joelucedo/MY-KICAD-LIBRARY/MY 3D MODELS/LED0603_BLUE.STEP

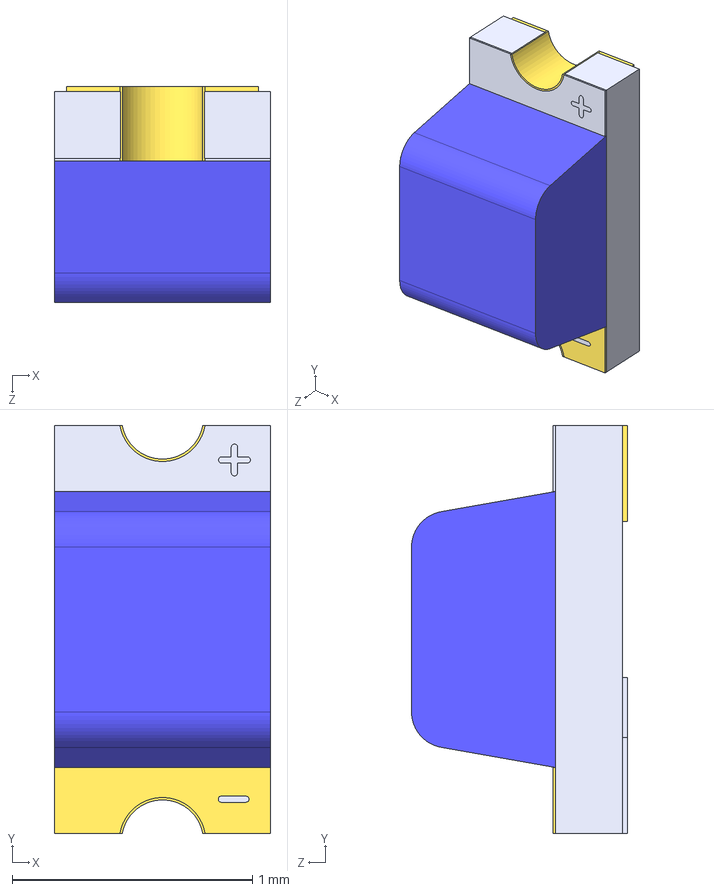
[picture p1: CAD file, 2023-07-05]
MY 3D MODELS/LED0603_BLUE.STEP
0.9 x 1.70 x 0.9 mm
User_Library-LTST-C190GKT_Pad005
User_Library-LTST-C190GKT_Pad001
User_Library-LTST-C190GKT_Pad006
User_Library-LTST-C190GKT_Pad004
User_Library-LTST-C190GKT_Pad003
User_Library-LTST-C190GKT_Pad007
User_Library-LTST-C190GKT_Lens
User_Library-LTST-C190GKT_Pad
String+
String-
