joelucedo/MY-KICAD-LIBRARY/MY 3D MODELS/VLS4012ET-4R7M.STEP

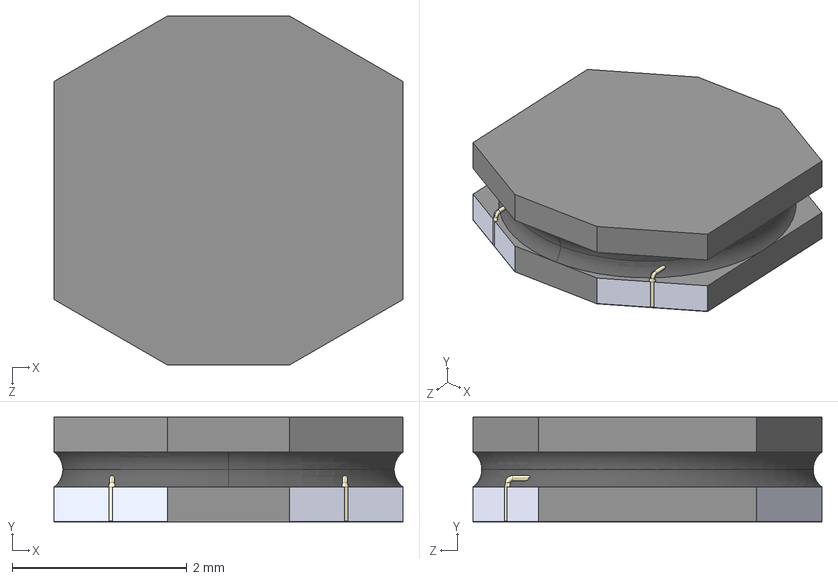
[picture p2: CAD file, 2023-07-02]
MY 3D MODELS/VLS4012ET-4R7M.STEP
4.00 x 1.20 x 4.00 mm
