joelucedo/MY-KICAD-LIBRARY/MY 3D MODELS/USBLC6-2SC6.step

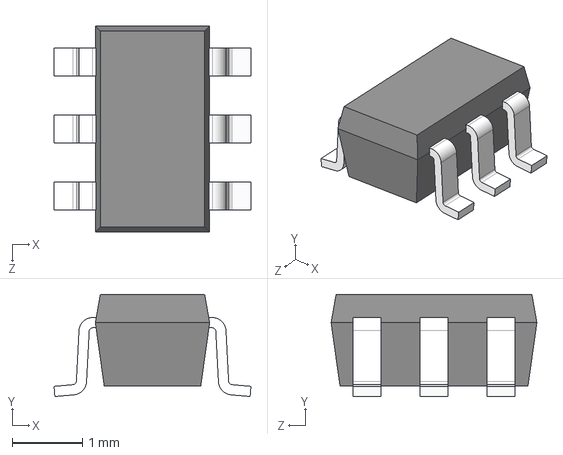
[picture p3: CAD file, 2023-07-01]
MY 3D MODELS/USBLC6-2SC6.step
2.80 x 1.45 x 2.92 mm
