joelucedo/MY-KICAD-LIBRARY/MY 3D MODELS/Inductor_CD32.STEP

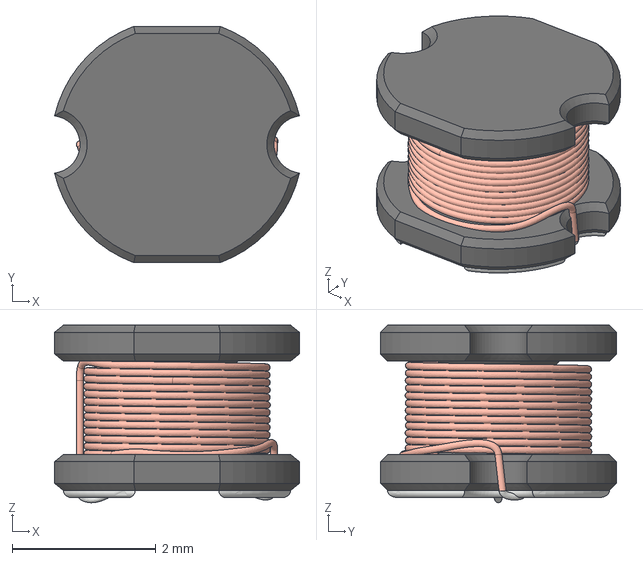
[picture p4: CAD file, 2023-07-01]
MY 3D MODELS/Inductor_CD32.STEP
3.41 x 3.29 x 2.47 mm
