joelucedo/MY-KICAD-LIBRARY/MY 3D MODELS/IRLML6401.stp

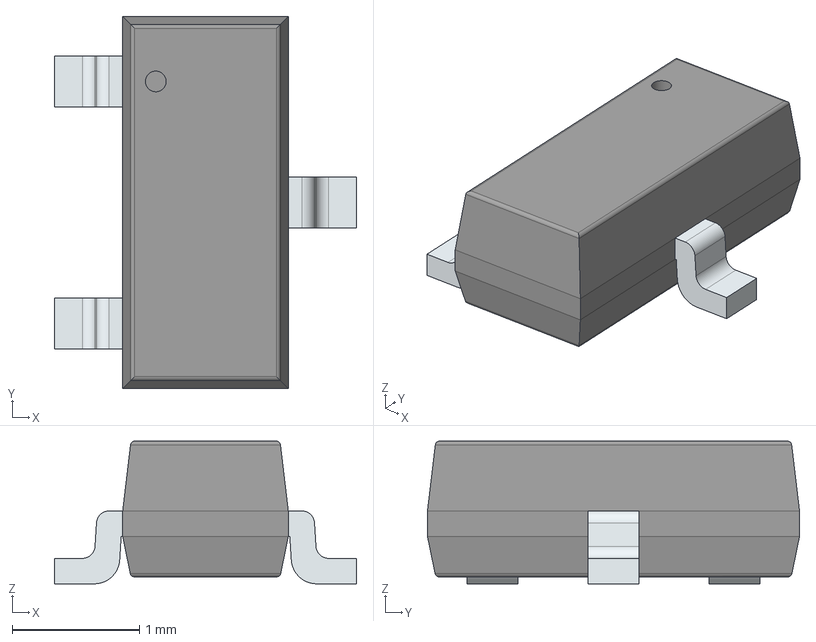
[picture p5: CAD file, 2023-06-07]
MY 3D MODELS/IRLML6401.stp
2.37 x 2.92 x 1.12 mm
PinsArrayL
FilletPinR
