joelucedo/MY-KICAD-LIBRARY/MY 3D MODELS/IS25WP064A-JBLE.stp

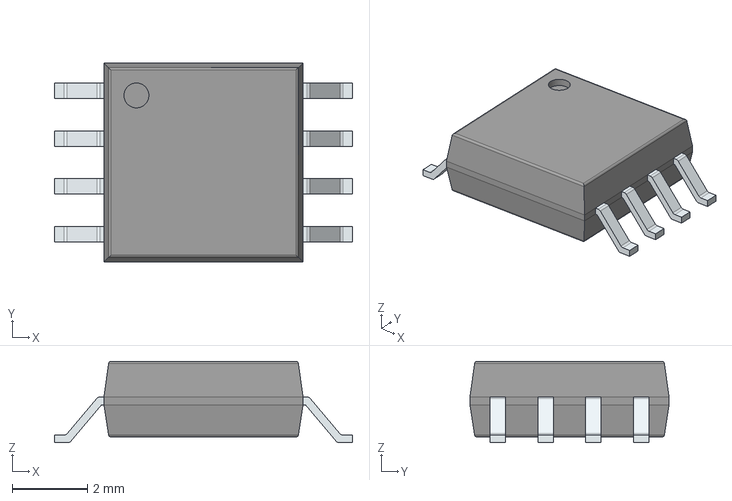
[picture p6: CAD file, 2023-06-07]
MY 3D MODELS/IS25WP064A-JBLE.stp
7.90 x 5.28 x 2.16 mm
PinsArrayLR
