joelucedo/MY-KICAD-LIBRARY/MY 3D MODELS/UM803RS.stp

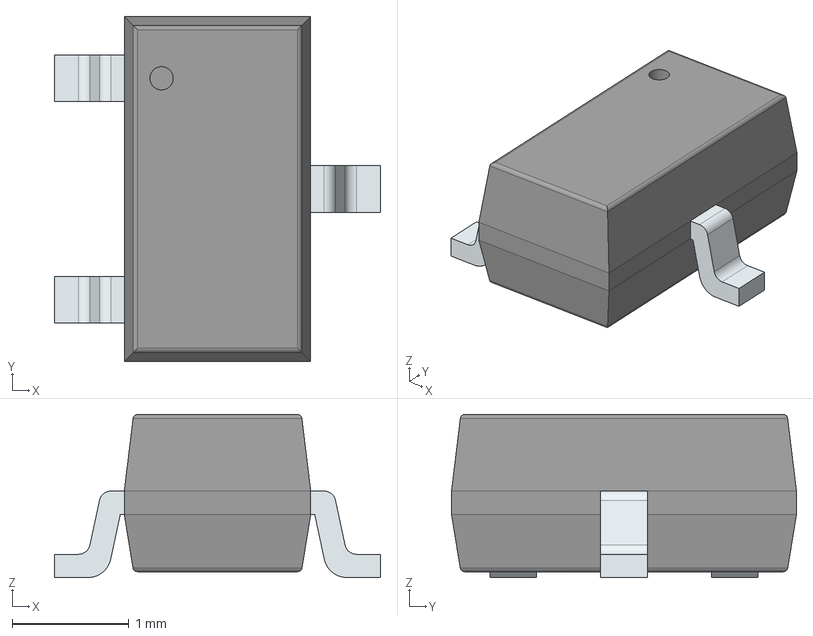
[picture p7: CAD file, 2023-06-07]
MY 3D MODELS/UM803RS.stp
2.80 x 2.96 x 1.40 mm
PinsArrayL
FilletPinR
