joelucedo/MY-KICAD-LIBRARY/MY 3D MODELS/UM805RE.STEP

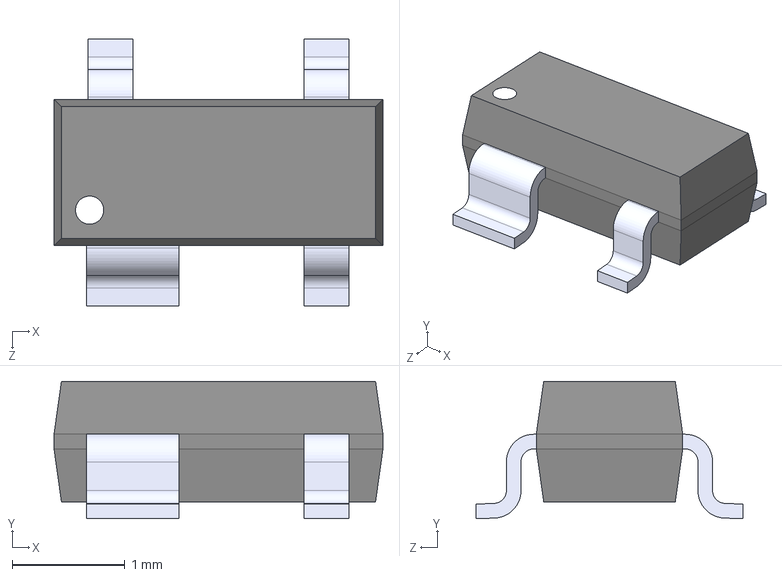
[picture p8: CAD file, 2023-06-07]
MY 3D MODELS/UM805RE.STEP
2.92 x 1.22 x 2.37 mm
