joelucedo/MY-KICAD-LIBRARY/MY 3D MODELS/XL7EL89CMI-111YLC-24M.stp

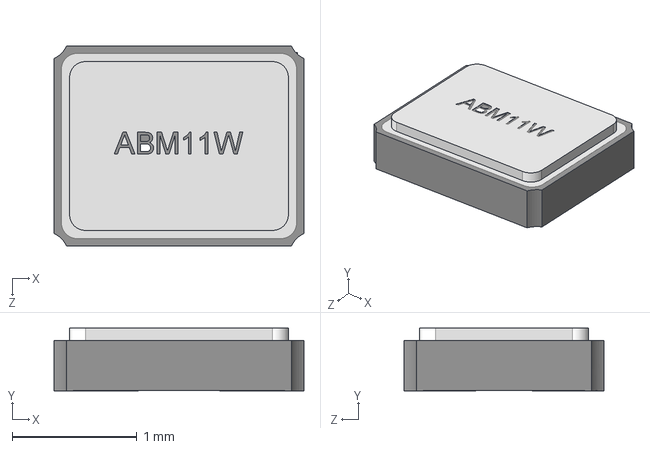
[picture p9: CAD file, 2023-06-07]
MY 3D MODELS/XL7EL89CMI-111YLC-24M.stp
2.00 x 0.5 x 1.60 mm
