joelucedo/MY-KICAD-LIBRARY/MY 3D MODELS/BLM18AG121SN1D.stp

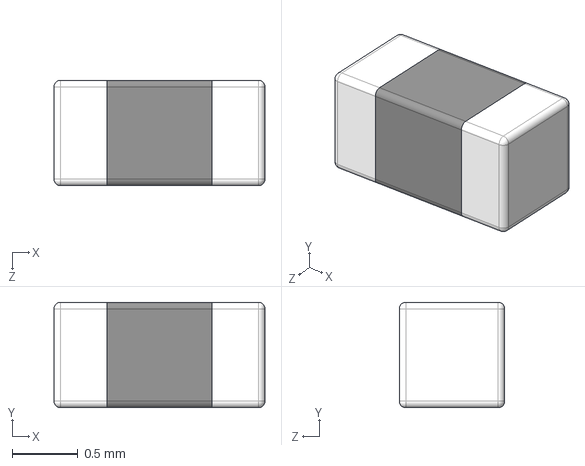
[picture p10: CAD file, 2023-06-07]
MY 3D MODELS/BLM18AG121SN1D.stp
1.60 x 0.8 x 0.8 mm
