joelucedo/MY-KICAD-LIBRARY/MY 3D MODELS/MIMXRT1064CVL5B.stp

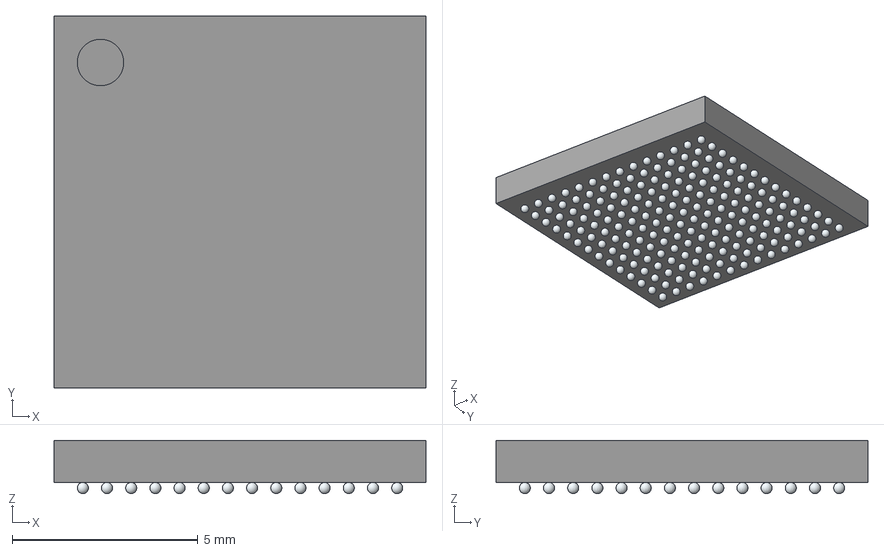
[picture p11: CAD file, 2023-06-07]
MY 3D MODELS/MIMXRT1064CVL5B.stp
10.0 x 10.0 x 1.43 mm
