joelucedo/MY-KICAD-LIBRARY/MY 3D MODELS/RB521S30.STEP

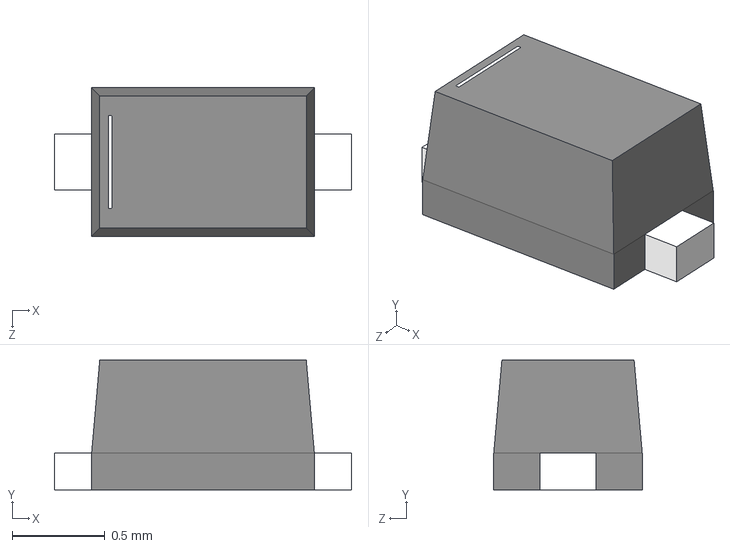
[picture p12: CAD file, 2023-06-07]
MY 3D MODELS/RB521S30.STEP
1.60 x 0.7 x 0.8 mm
