joelucedo/MY-KICAD-LIBRARY/MY 3D MODELS/SY8089AAAC.STEP

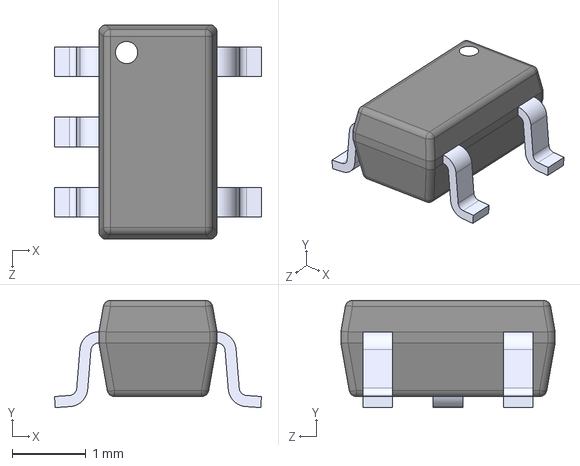
[picture p14: CAD file, 2023-06-07]
MY 3D MODELS/SY8089AAAC.STEP
2.80 x 1.45 x 2.90 mm
