joelucedo/MY-KICAD-LIBRARY/MY 3D MODELS/SP0503BAHTG.stp

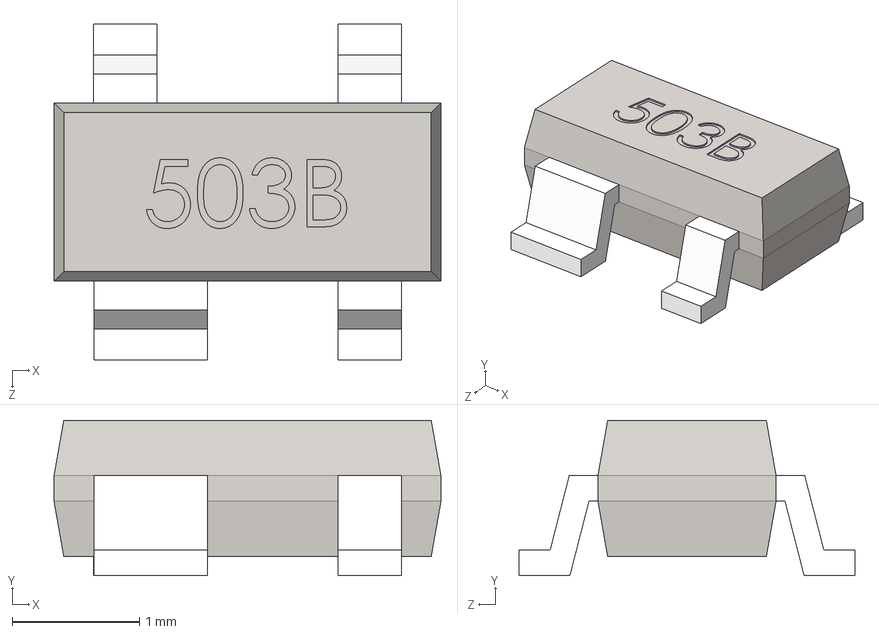
[picture p15: CAD file, 2023-06-07]
MY 3D MODELS/SP0503BAHTG.stp
3.04 x 1.22 x 2.64 mm
