joelucedo/MY-KICAD-LIBRARY/MY 3D MODELS/7V24000026.STEP

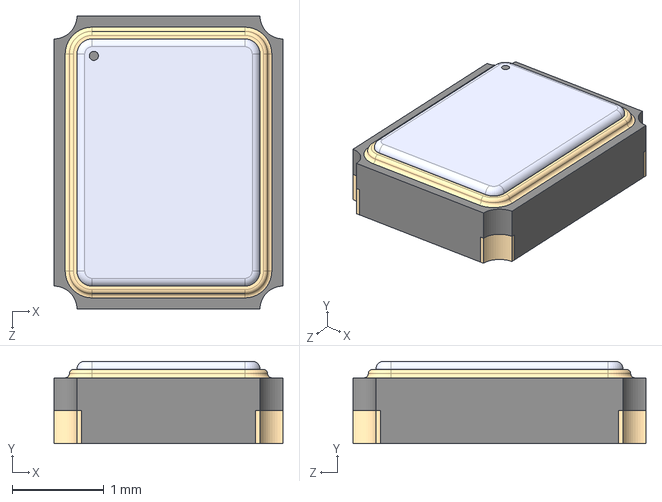
[picture p16: CAD file, 2023-06-07]
MY 3D MODELS/7V24000026.STEP
2.50 x 0.9 x 3.20 mm
