joelucedo/MY-KICAD-LIBRARY/MY 3D MODELS/WM8978CGEFL_RV.stp

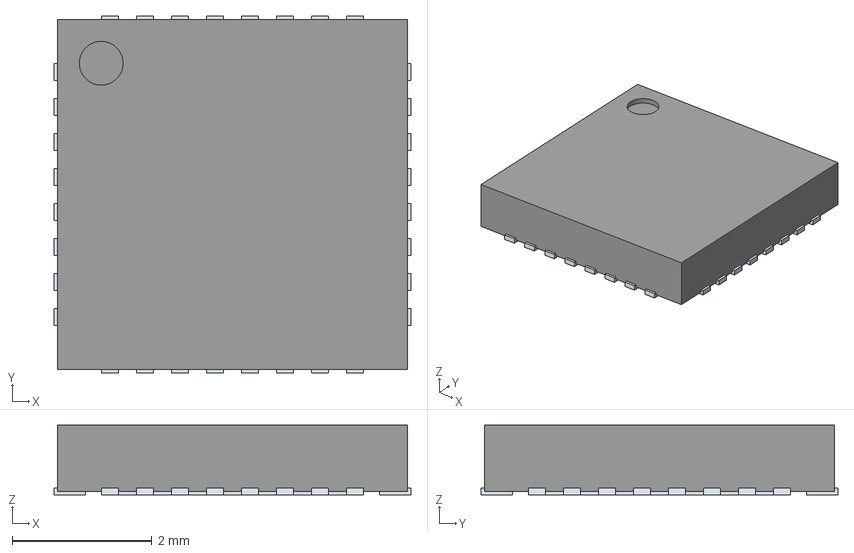
[picture p18: CAD file, 2023-06-07]
MY 3D MODELS/WM8978CGEFL_RV.stp
5.10 x 5.10 x 1.00 mm
ThermalPin
PinsArrayLR
PinsArrayTB
