joelucedo/MY-KICAD-LIBRARY/MY 3D MODELS/Q13FC1350000200.STEP

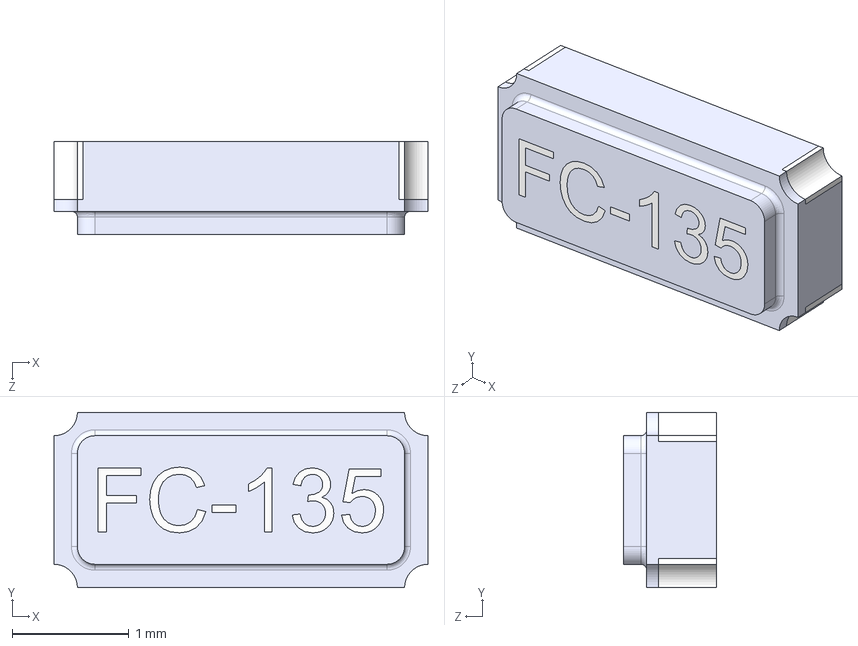
[picture p19: CAD file, 2023-06-07]
MY 3D MODELS/Q13FC1350000200.STEP
3.20 x 1.50 x 0.8 mm
Pin 2
Pin 1
Tekst Inlay
