joelucedo/MY-KICAD-LIBRARY/MY 3D MODELS/801-87-008-10-001101.stp

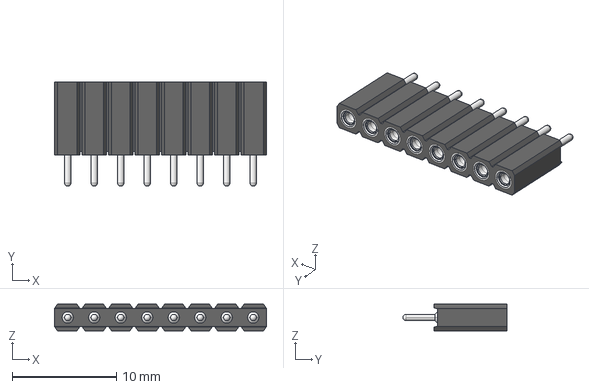
[picture p20: CAD file, 2023-06-02]
MY 3D MODELS/801-87-008-10-001101.stp
20.3 x 10.00 x 2.54 mm
