joelucedo/MY-KICAD-LIBRARY/MY 3D MODELS/RK09D1130C2P.stp

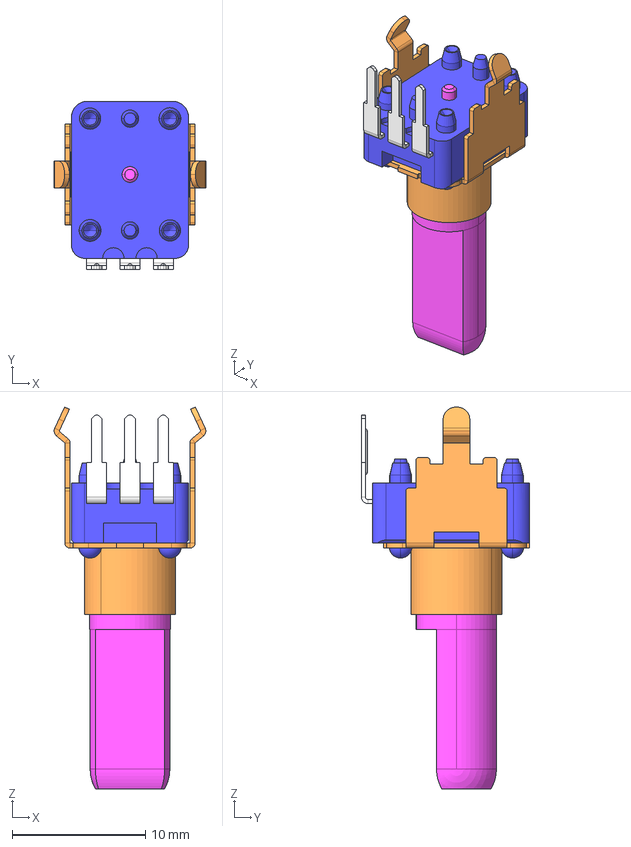
[picture p21: CAD file, 2023-06-02]
MY 3D MODELS/RK09D1130C2P.stp
11.4 x 12.7 x 28.7 mm
