joelucedo/MY-KICAD-LIBRARY/MY 3D MODELS/ESP32-WROVER-IE_(16MB).step

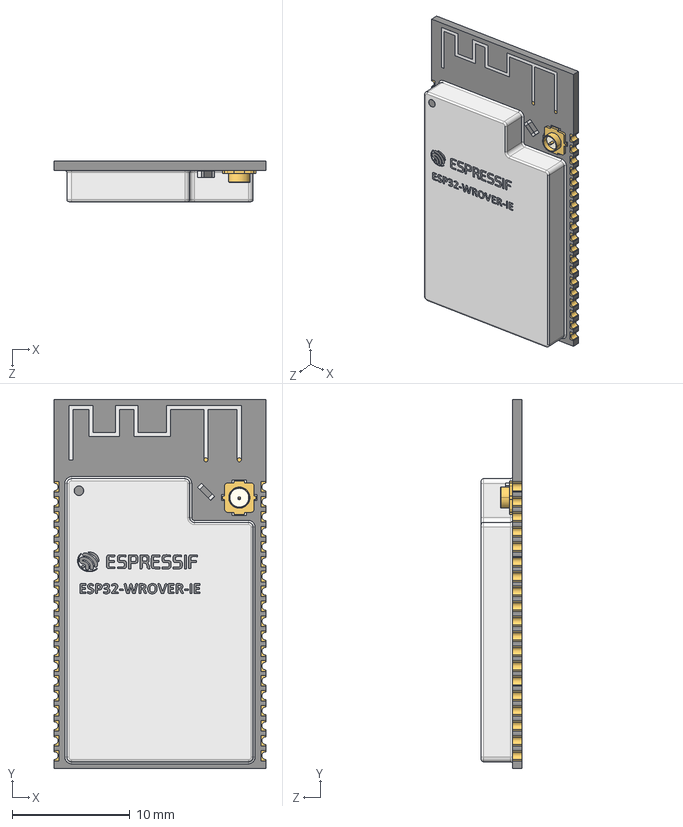
[picture p22: CAD file, 2023-06-02]
MY 3D MODELS/ESP32-WROVER-IE_(16MB).step
18.0 x 31.4 x 3.45 mm
Cover
Bottom Gold
Connector PTFE
Connector
Connector FP
Resistor Body
Resistor Terminal
Antenna Trace
Gold Dot
Pins
0.8mm
Espressif Logo
