joelucedo/MY-KICAD-LIBRARY/MY 3D MODELS/74HC04D,653.stp

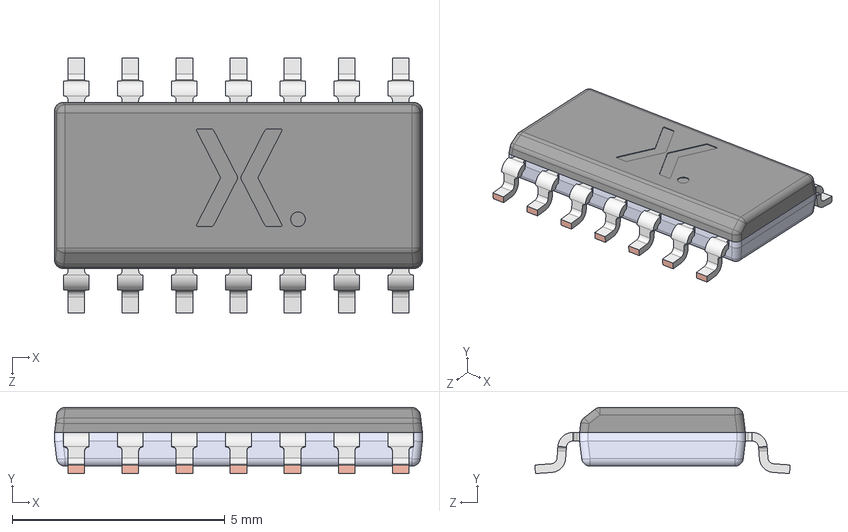
[picture p23: CAD file, 2023-06-02]
MY 3D MODELS/74HC04D,653.stp
8.65 x 1.56 x 6.00 mm
SOT108 lower body
SOT108 upper body
SOT108-1 Lead
