joelucedo/MY-KICAD-LIBRARY/MY 3D MODELS/TS-1187A-B-A-B.STEP

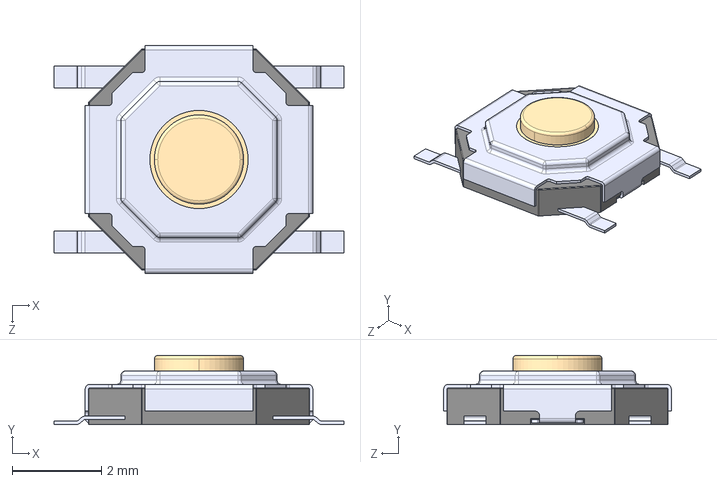
[picture p24: CAD file, 2023-06-02]
MY 3D MODELS/TS-1187A-B-A-B.STEP
6.50 x 1.55 x 5.10 mm
