joelucedo/MY-KICAD-LIBRARY/MY 3D MODELS/PJ-342B-TX-SMT.stp

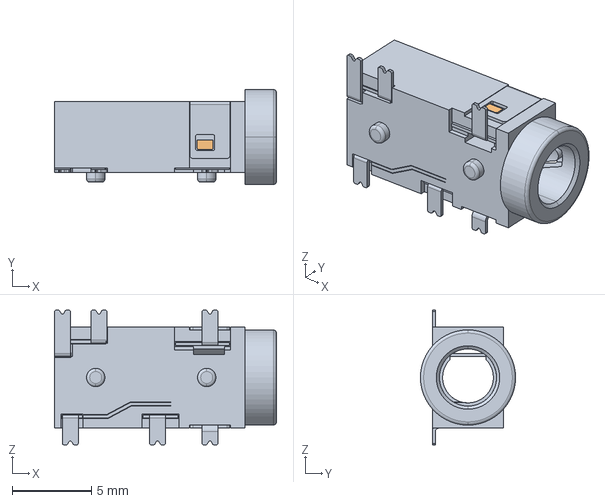
[picture p25: CAD file, 2023-06-02]
MY 3D MODELS/PJ-342B-TX-SMT.stp
14.0 x 6.00 x 8.50 mm
