joelucedo/MY-KICAD-LIBRARY/MY 3D MODELS/GCT_USB4105-GF-A-060.STEP

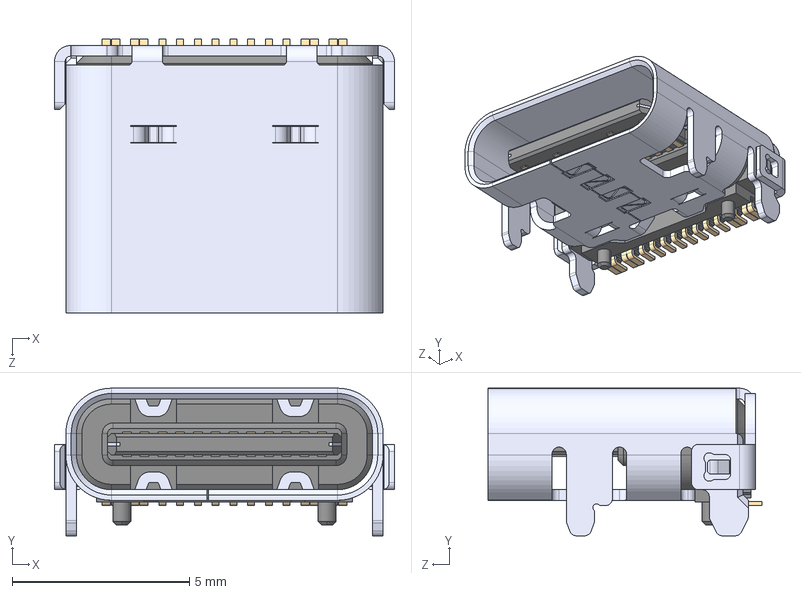
[picture p26: CAD file, 2023-06-02]
MY 3D MODELS/GCT_USB4105-GF-A-060.STEP
9.58 x 4.16 x 7.71 mm
