joelucedo/MY-KICAD-LIBRARY/MY 3D MODELS/PEC12R-4025F-S24.stp

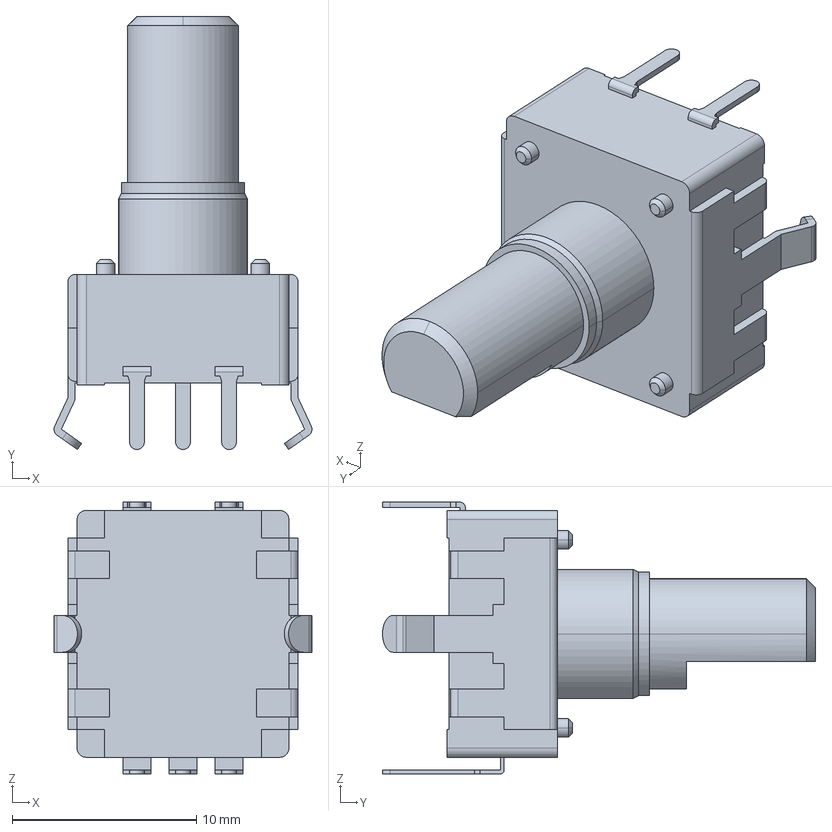
[picture p27: CAD file, 2023-06-02]
MY 3D MODELS/PEC12R-4025F-S24.stp
14.0 x 23.5 x 14.7 mm
