joelucedo/MY-KICAD-LIBRARY/(list of files, cad)

Other CAD files:
MY 3D MODELS/X201232768KJD2SI.step
