joelucedo/MY-KICAD-LIBRARY/(commit log)

2023-05-27 schematic updates
2023-05-27 Update MY CONNECTOR LIBRARY.kicad_sym
